hanshuebner/symbolics-keyboard/README.md

This repository contains code and information regarding the Symbolics
keyboard.

Please see my blog posts regarding the subject:

* http://netzhansa.blogspot.com/2008/05/symbolics-keyboard-on-ps2-port.html
* http://netzhansa.blogspot.com/2009/04/reimplementing-symbolics-keyboard.html
* http://netzhansa.blogspot.com/2009/04/how-to-convert-your-symbolics-keyboard.html
* http://netzhansa.blogspot.com/2010/06/how-to-convert-your-old-style-symbolics.html
