hanshuebner/symbolics-keyboard/layout.pdf

# kbdbabel-symbolics Symbolics to PS/2 Adapter key code mapping

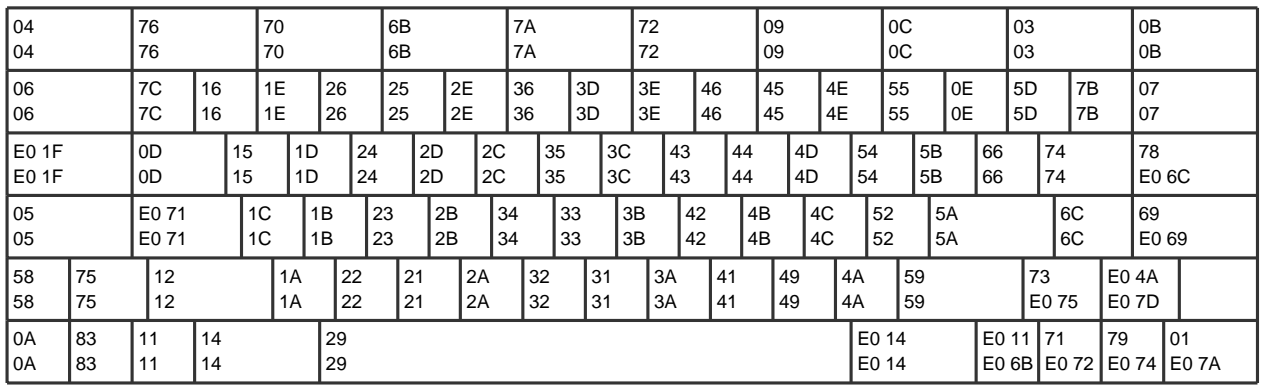
[picture p1: figure]

kbdbabel for Symbolics keyboard - by Alexander Kurz and Hans Hübner - http://kbdbabel.net/

## PS/2 scan codes (top: standard, bottom: F-mode)

## F-Mode mapping

F8 F7

Alt
L

Ctrl
L | Space

Ctrl
R | Left | Down | Right

Pg
Dn

Caps KP8

Shift
L | Z | X | C | V | B | N | M | , | . | /

Shift
R | Up

Pg
Up

F-Mode
Lock
F1 | Del | A | S | D | F | G | H | J | K | L | ; | ' | Return | KP7 | End

Windows
L | Tab | Q | W | E | R | T | Y | U | I | O | P | [ | ]

Back
Space | KP6 | Home
F2 | KP* | 1 | 2 | 3 | 4 | 5 | 6 | 7 | 8 | 9 | 0 | - | = | ` | \ | KP- | F12
F3 | Escape | KP0 | KP4 | KP3 | KP2 | F10 | F4 | F5 | F6

## Standard mapping

F8 F7

Alt
L

Ctrl
L | Space

Ctrl
R

Alt
Gr | KP. | KP+ | F9
Caps | KP8

Shift
L | Z | X | C | V | B | N | M | , | . | /

Shift
R | KP5 | KP/

F-Mode
Lock
F1 | Del | A | S | D | F | G | H | J | K | L | ; | ' | Return | KP7 | KP1

Windows
L | Tab | Q | W | E | R | T | Y | U | I | O | P | [ | ]

Back
Space | KP6 | F11
F2 | KP* | 1 | 2 | 3 | 4 | 5 | 6 | 7 | 8 | 9 | 0 | - | = | ` | \ | KP- | F12
F3 | Escape | KP0 | KP4 | KP3 | KP2 | F10 | F4 | F5 | F6

## Key caps

Hyper
L

Super
L

Meta
L

Control
L | Space

Control
R

Meta
R

Super
R

Hyper
R Scroll

Caps
Lock

Symbol
L

Shift

L | Z | X | C | V | B | N | M | <
, | >
. | ?
/

Shift
R

Symbol
R Repeat

Mode
Lock

Select

Rub

Out | A | S | D | F | G | H | J | K | L | :
; | "
' | Return | Line | End
Local | Tab | Q | W | E | R | T | Y | U | I | O | P

[
(

]
)

Back
Space | Page | Complete
Network | : | !
| | 1

@
2
3

$
4

%

5 | ^
| 6

&

7 | *
| 8

(
9

)

0 _

- +
= | ~
` | {
\

}
| | Help
Function | Escape | Refresh | Square | Circle | Triangle

Clear
Input | Suspend | Resume | Abort
