hanshuebner/symbolics-keyboard/keyboard.gif

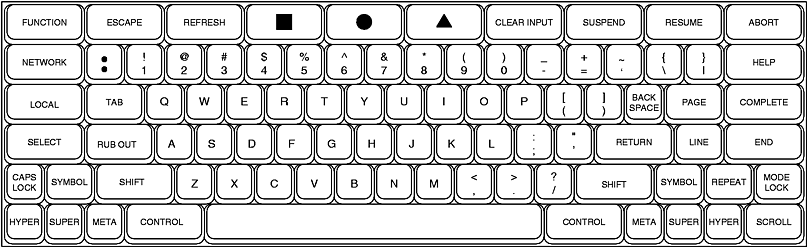
keyboard.gif
