hanshuebner/symbolics-keyboard/teensy-firmware/symbolics.c

// -*- C++ -*- (this is really C)

// -*- C++ -*-

// Symbolics keyboard to USB adapter

// See the README.txt file for documentation

// Copyright 2009 by Hans Huebner (hans.huebner@gmail.com).
// Additional copyrights apply.

// This is the original copyright notice for this file:

/* Keyboard example for Teensy USB Development Board
 * http://www.pjrc.com/teensy/usb_keyboard.html
 * Copyright (c) 2008 PJRC.COM, LLC
 * 
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
 * THE SOFTWARE IS PROVIDED "AS IS", WITHOUT WARRANTY OF ANY KIND, EXPRESS OR
 * IMPLIED, INCLUDING BUT NOT LIMITED TO THE WARRANTIES OF MERCHANTABILITY,
 * FITNESS FOR A PARTICULAR PURPOSE AND NONINFRINGEMENT. IN NO EVENT SHALL THE
 * AUTHORS OR COPYRIGHT HOLDERS BE LIABLE FOR ANY CLAIM, DAMAGES OR OTHER
 * LIABILITY, WHETHER IN AN ACTION OF CONTRACT, TORT OR OTHERWISE, ARISING FROM,
 * OUT OF OR IN CONNECTION WITH THE SOFTWARE OR THE USE OR OTHER DEALINGS IN
 * THE SOFTWARE.
 */

#undef DEBUG

#include <avr/io.h>
#include <avr/pgmspace.h>
#include <avr/interrupt.h>
#include <util/delay.h>
#include <string.h>
#if defined(DEBUG)
#include "debug.h"
#else
#include "usb_keyboard.h"
#endif

#define CPU_PRESCALE(n)	(CLKPR = 0x80, CLKPR = (n))

#define NUM_KEY_LEFT_CTRL   0
#define NUM_KEY_LEFT_SHIFT  1
#define NUM_KEY_LEFT_ALT    2
#define NUM_KEY_LEFT_GUI    3
#define NUM_KEY_RIGHT_CTRL  4
#define NUM_KEY_RIGHT_SHIFT 5
#define NUM_KEY_RIGHT_ALT   6
#define NUM_KEY_RIGHT_GUI   7
#define NUM_KEY_LOCAL       8
#define NUM_KEY_F_MODE      9
#define NUM_KEY_CAPS_LOCK   10

#include "keymap.inc"

// D4: data in (with pull-up enabled)
// D5: clock output (active low)
// D6: clear output (active low)

#define MASK_DIN 0x10
#define MASK_CLOCK 0x20
#define MASK_CLEAR 0x40

void
init_keyboard_interface(void)
{
  // Initialize I/O ports used to interface to the keyboard
  
  DDRD = MASK_CLOCK | MASK_CLEAR;
  PORTD = MASK_CLOCK | MASK_CLEAR | MASK_DIN;
}

void
poll_keyboard(uint8_t* state)
{
  // Read the keyboard shift register into the memory region pointed
  // to by state.
  
  PORTD &= ~MASK_CLEAR;
  _delay_us(10);
  PORTD |= MASK_CLEAR;
  _delay_us(100);
  for (int i = 0; i < 16; i++) {
    uint8_t buf = 0;
    for (int j = 0; j < 8; j++) {
      buf >>= 1;
      PORTD &= ~MASK_CLOCK;
      _delay_us(7);
      PORTD |= MASK_CLOCK;
      _delay_us(40);
      if (!(PIND & MASK_DIN)) {
        buf |= 0x80;
      }
    }
    state[i] = buf;
  }
}

void
jump_to_loader(void)
{
  // Jump to the HalfKay (or any other) boot loader

  USBCON = 0;
  asm("jmp 0x3000");
}

void
send_keys(uint8_t* state)
{
  // Report all currently pressed keys to the host.  This function
  // will be called when a change of state has been detected.
  
  uint8_t local = 0;
  uint8_t caps_lock_pressed = 0;
  const uint8_t* keymap = keymap_normal;

 retry:
  // If we detect that we are in f-mode, we need to translate the
  // pressed keys with the f-mode translation table.  Detection of
  // f-mode happens while decoding the shift register.  When the
  // f-mode key is detected as being pressed, the translation table is
  // switched and the decoding process is restarted.
  {
    uint8_t key_index = 0;
    uint8_t map_index = 0;
    keyboard_modifier_keys = 0;
    memset(keyboard_keys, 0, sizeof keyboard_keys);

    for (int i = 0; i < 16; i++) {
      uint8_t buf = state[i];
      for (int j = 0; j < 8; j++, map_index++) {
        uint8_t mapped = pgm_read_byte(&keymap[map_index]);
        uint8_t pressed = (buf & 1);
#if defined(DEBUG)
        if (pressed) {
          print("key ");
          phex(map_index - 1);
          print(" pressed, mapped to ");
          phex(mapped);
          print("\n");
        }
#endif
        // Handle firmware update key combination Local+Abort

        if (pressed) {
          if (map_index == 0x01) {
            local = 1;                                      // Local key is pressed
          } else if (map_index == 0x1e && local) {
            jump_to_loader();                               // Abort key is pressed
          }
        }            

        if (pressed && mapped) {
          if (mapped & 0x80) {
            int num = mapped & 0x7F;
            switch (num) {

            case NUM_KEY_LEFT_CTRL:
            case NUM_KEY_LEFT_SHIFT:
            case NUM_KEY_LEFT_ALT:
            case NUM_KEY_LEFT_GUI:
            case NUM_KEY_RIGHT_CTRL:
            case NUM_KEY_RIGHT_SHIFT:
            case NUM_KEY_RIGHT_ALT:
            case NUM_KEY_RIGHT_GUI:
              keyboard_modifier_keys |= 1 << num;
              break;

            case NUM_KEY_F_MODE:
              if (keymap == keymap_normal) {
                keymap = keymap_f_mode;
                goto retry;
              }
              break;

            case NUM_KEY_CAPS_LOCK:
              caps_lock_pressed = 1;
              break;

            }
          } else {
            if (key_index < sizeof keyboard_keys) {
              keyboard_keys[key_index++] = mapped;
            }
          }
        }
        buf >>= 1;
      }
    }
  }
  
#if !defined(DEBUG)
  usb_keyboard_send();
#endif

  {
    // Process caps lock key.  This key is a switch on the Symbolics
    // keyboard, so we must make sure that the current switch setting
    // always matches the caps lock state of the host.

    // If the host set LED 2, it indicates that caps lock has been
    // pressed.  If the caps lock state reported by the host does not
    // match the caps lock key state of the Symbolics keyboard, send a
    // "caps lock" key press and release to the host to make the two
    // match.  As a result, if caps lock is depressed on another
    // keyboard connected to the host, it will quickly be cleared
    // again.

    uint8_t prev_caps_lock_pressed = (keyboard_leds & 2) ? 1 : 0;
    if (caps_lock_pressed ^ prev_caps_lock_pressed) {
      usb_keyboard_press(KEY_CAPS_LOCK, 0);
    }
  }
}

int
main(void)
{
  static uint8_t state[16];
  static uint8_t prev_state[16];

  // set for 16 MHz clock
  CPU_PRESCALE(0);

  init_keyboard_interface();

  // Initialize the USB, and then wait for the host to set configuration.
  // If the Teensy is powered without a PC connected to the USB port,
  // this will wait forever.
  usb_init();
  while (!usb_configured()) /* wait */ ;

  // Wait for the PC's operating system to load drivers
  // and do whatever it does to actually be ready for input
  _delay_ms(3000);

  memset(prev_state, 0, sizeof prev_state);
  while (1) {
    poll_keyboard(state);
    if (memcmp(state, prev_state, sizeof state)) {
      send_keys(state);
      memcpy(prev_state, state, sizeof state);
    }
    _delay_ms(10);
  }
}
