hanshuebner/symbolics-keyboard/(commit log)

2008-06-03 Add scan code documentation from Microsoft. Modify layout so that Local is the Windows key, not F-Mode Shift, suggested by Bill Clementson.
    [ps2-scancodes.xls]
2009-04-06 Add first version of Teensy based Symbolics keyboard adapter firmware.
2009-06-24 big oops: fix swapped vcc and gnd lines, thanks to gene diveglia for reporting
2009-06-24 shorten clock pulse to 8us, reported to work better by gene diveglia
    [symbolics.c]
2013-02-10 update for teensy 2.0
2015-01-03 Map Local key to Windows/Command
    When using the USB converter with a Mac, the lack of a mapping for the
    Command key becomes a real issue. With this change, the Local key is
    mapped as Command (Windows) key. The version report key (Local-V) is
    gone, the boot loader jump function is now mapped to Local+Abort.
    The build process now builds both Teensy 1 and Teensy 2 versions of the
    firmware. Both hex files are stored in GitHub.
    The timing has been slightly changed again, but there are still some
    issues which cause unwanted keys to be pressed. Any reports regarding
    this and possible timing fixes would be welcome.
    [symbolics.c]
